buildwithnoknok/module-I2C-1.42-display/hardware/BOM_module-I2C-Display_1_42inch.xls

Item # | *Designator | *Qty | Manufacturer | *Mfg Part # | Description / Value | LCSC Part # | *Package/Footprint | Your Instructions / Notes | Substitute
1 | C1, C7 | 2 | YAGEO | CC0603MRX5R8BB106 | 10uF / CAP CER 10uF 25V X5R 0603 | C596327 | C_0603_1608Metric |  | SAMSUNG『 』CL10A106KP8NNNC『 』C19702
2 | C2, C4, C5, C8 | 4 | YAGEO | CC0603KRX7R9BB104 | 0.1uF / CAP CER 100nF 50V X7R 0603 | C14663 | C_0603_1608Metric |  | SAMSUNG『 』CL10B104KA8NNNC『 』C1590
3 | C6 | 1 | YAGEO | CC1206KKX5R8BB226 | 22µF 25V / CAP CER 22uF 25V X5R 1206 | C2178233 | C_0603_1608Metric |  | SAMSUNG『 』CL10A226MP8NUNE『 』C86295
4 | C9 | 1 | YAGEO | CC0603KRX7R9BB105 | 1uF / CAP CER 1uF 50V X7R 0603 | C559769 | C_0603_1608Metric |  | SAMSUNG『 』CL10A105KP8NNNC『 』C26413
5 | D2 | 1 | onsemi | MM3Z3V6T1G | D_Zener | C116949 | D_SOD-323 |  | ROHM『 』UDZVTE-173.6B『 』C209558
6 | D3 | 1 | onsemi | NSR0320MW2T1G | D_Schottky | C48192 | D_SOD-323
7 | D4 | 1 | Hubei KENTO Elec | KT-0603R | LED RED WATER CLEAR 0603 SMD | C2286 | C_0603_1608Metric
8 | DS1 | 1 | EastRising | ER-TFT1.42-1 | 1.42”IPS TFT LCD 80x160 Pixels Display Panel | --- | ER-TFT1.42-1_13pin_solder | https://www.buydisplay.com/1-42-inch-color-80x160-ips-tft-lcd-display-panel-nv3022b-connector
9 | J1, J2 | 2 | JST | SM04B-SRSS-TB(LF)(SN) | JST 4 Pin Qwiic I2C Connector | C160404 | JST_SH_SM04B-SRSS-TB_1x04-1MP_P1.00mm_Horizontal
10 | L1 | 1 | cjiang | FTC252010S4R7MBCA | Inductor 4.7uH | C5832360 | L_Changjiang_FTC252010S
11 | Q1 | 1 | AOS | AO3400A | MOSFET N-CH 30V SOT-23-3L | C20917 | SOT-23
12 | R1 | 1 | YAGEO | RC0603JR-0710RL | 10R | C109317 | R_0603_1608Metric |  | Viking『 』ARG03FTC0100『 』C217691
13 | R10 | 1 | YAGEO | RC0603JR-07100RL | 100R | C110091 | R_0603_1608Metric |  | Viking『 』ARG03FTC1000『 』C217683
14 | R2 | 1 | YAGEO | RC0603JR-0710KL | 10k | C99198 | R_0603_1608Metric |  | Viking『 』ARG03FTC1002『 』C217687
15 | R3 | 1 | YAGEO | RC0603JR-0733KL | 33k | C138564 | R_0603_1608Metric |  | Viking『 』ARG03FTC3302『 』C217971
16 | R4 | 1 | YAGEO | RC0603JR-0712KL | 12k | C137662 | R_0603_1608Metric |  | Viking『 』ARG03FTC1202『 』C217716
17 | R5 | 1 | YAGEO | RC0603JR-072K2L | 2.2k | C113303 | R_0603_1608Metric |  | Viking『 』ARG03FTC2201『 』C217937
18 | R6, R7 | 2 | YAGEO | RC0603JR-0722RL | 22R | C108405 | R_0603_1608Metric |  | Viking『 』ARG03FTC0220『 』C217888
19 | R8 | 1 | YAGEO | RC0603JR-0733RL | 33R | C108407 | R_0603_1608Metric |  | Viking『 』ARG03FTC0330『 』C217973
20 | R9 | 1 | YAGEO | RC0603JR-07100KL | 100k | C100048 | R_0603_1608Metric |  | Viking『 』ARG03FTC1003『 』C217682
21 | U1 | 1 | WCH | CH32V003F4U6 | CH32V003F4U6 | C5299908 | QFN-20-1EP_3x3mm_P0.4mm_EP1.65x1.65mm
22 | U2 | 1 | XI'AN Aerosemi Tech | MT3540-F23 | MT3540-F23 | C181783 | SOT-23-5
