buildwithnoknok/module-I2C-1.42-display/hardware/module-I2C-Display_1_42inch_Schematics.pdf

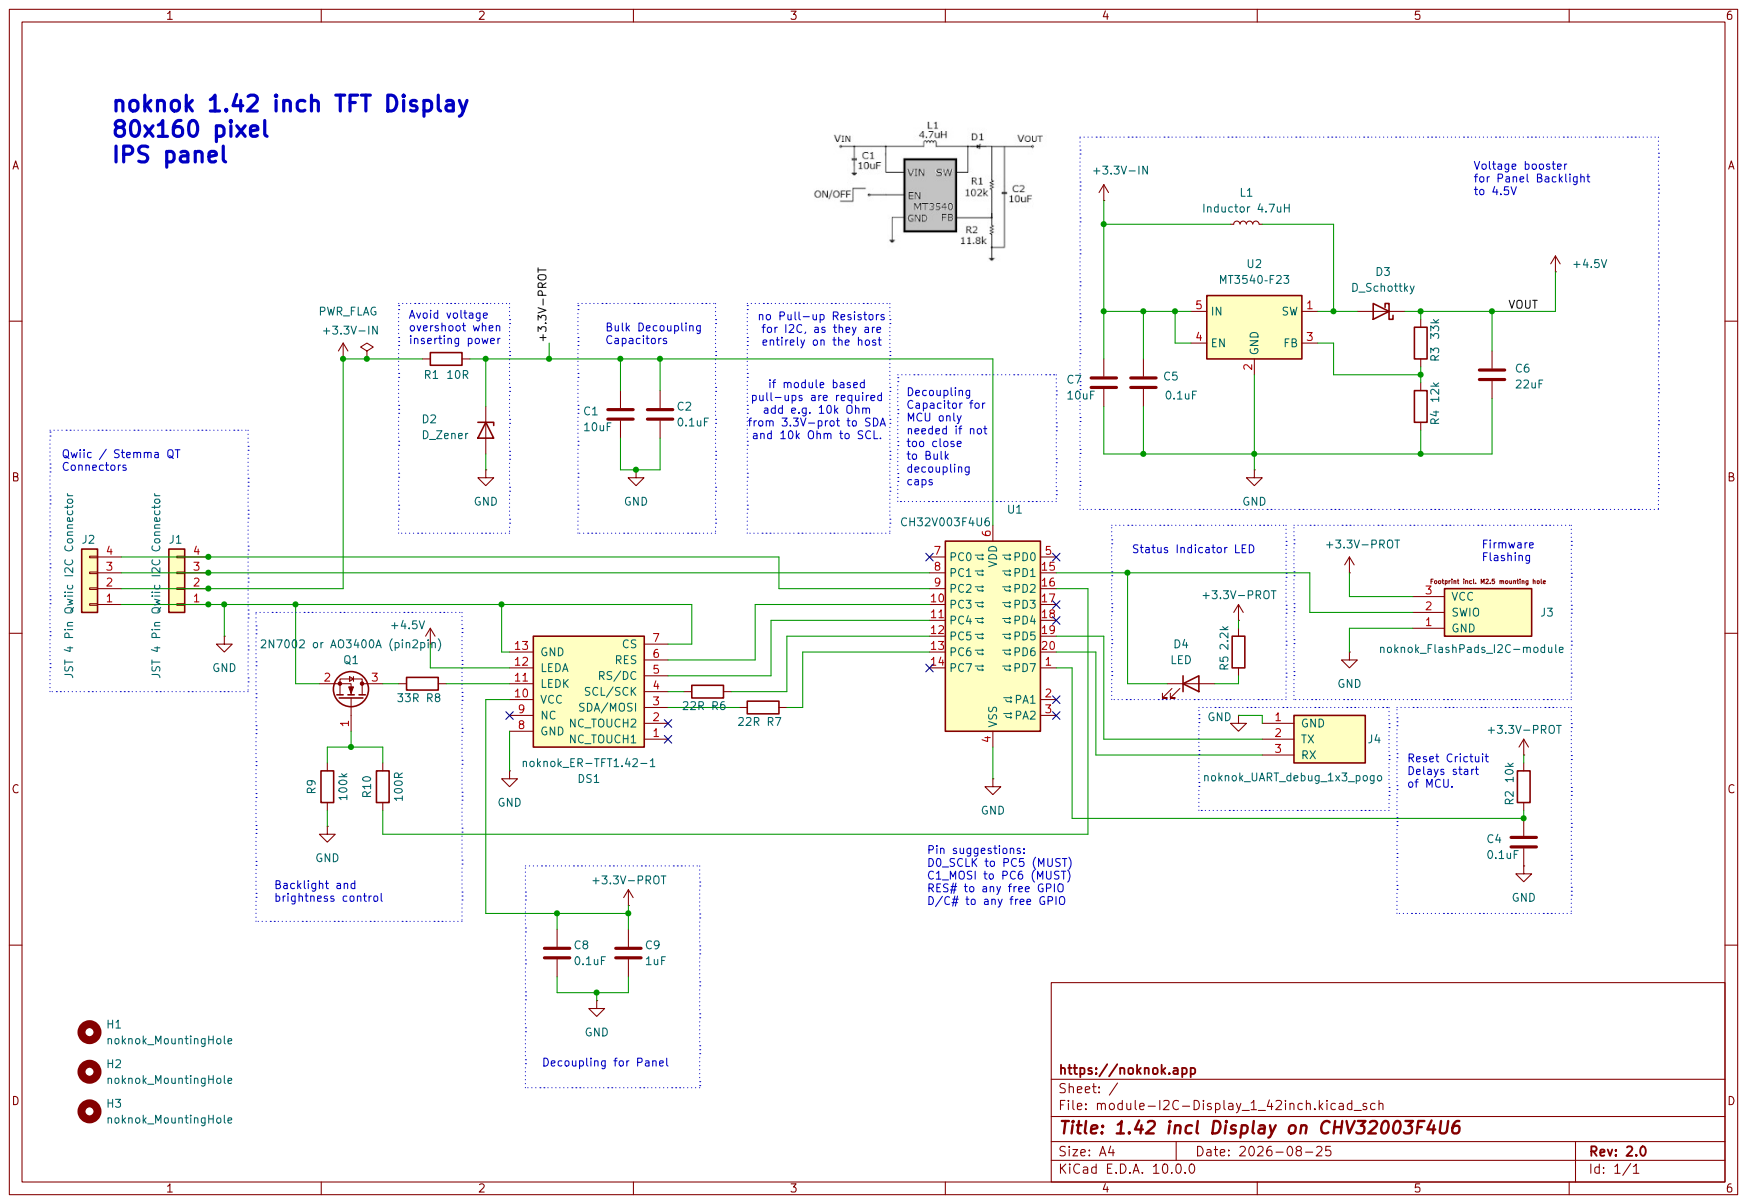
[picture p1: page 1]
