buildwithnoknok/module-I2C-1.42-display/hardware/kicad/module-I2C-Display_1_42inch.kicad_pcb

## KiCad design hardware/kicad/module-I2C-Display_1_42inch.kicad_pcb (2026-08-25)

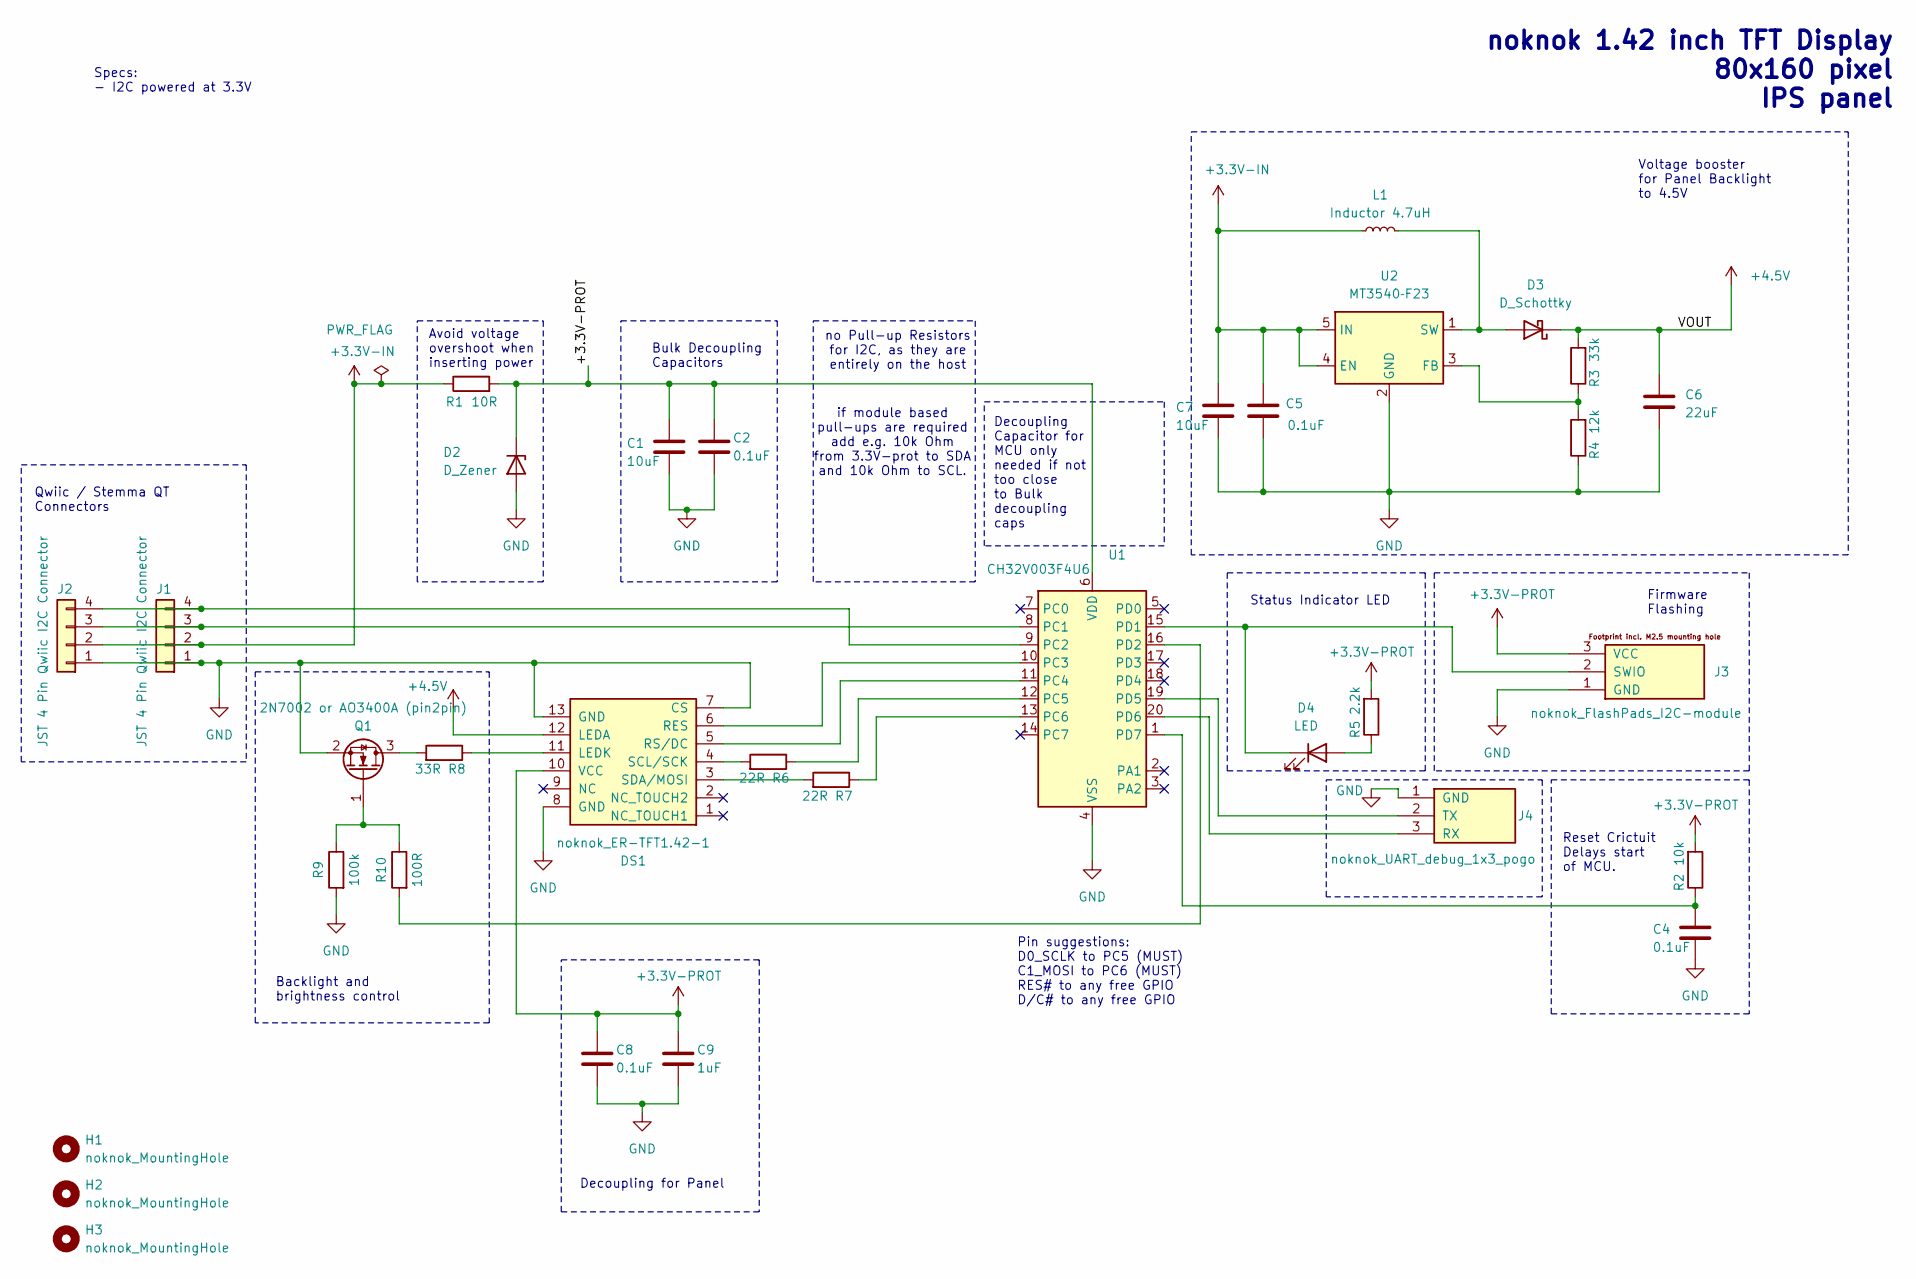
[picture p2: schematic module-I2C-Display_1_42inch.kicad_sch, 1.42 incl Display on CHV32003F4U6]

Parts:
C1, C7: 10uF; C_0603_1608Metric
C2, C4, C5, C8: 0.1uF; C_0603_1608Metric
C6: 22uF; C_0603_1608Metric
C9: 1uF; C_0603_1608Metric
D2: D_Zener; D_SOD-323
D3: D_Schottky; D_SOD-323
D4: LED; LED_0603_1608Metric
DS1: noknok_ER-TFT1.42-1; noknok_ER-TFT1.42-1_13pin_solder_proto
H1, H2, H3: noknok_MountingHole; noknok_MountingHole_2.5mm_M2.5
J1, J2: JST 4 Pin Qwiic I2C Connector; JST_SH_SM04B-SRSS-TB_1x04-1MP_P1.00mm_Horizontal
J3: noknok_FlashPads_I2C-module; noknok_FlashPads_I2C-module_1x3_M2.5
J4: noknok_UART_debug_1x3_pogo
L1: Inductor 4.7uH; L_Changjiang_FTC252010S
Q1: 2N7002 or AO3400A (pin2pin); SOT-23
R1: 10R; R_0603_1608Metric
R2: 10k; R_0603_1608Metric
R3: 33k; R_0603_1608Metric
R4: 12k; R_0603_1608Metric
R5: 2.2k; R_0603_1608Metric
R6, R7: 22R; R_0603_1608Metric
R8: 33R; R_0603_1608Metric
R9: 100k; R_0603_1608Metric
R10: 100R; R_0603_1608Metric
U1: CH32V003F4U6; QFN-20-1EP_3x3mm_P0.4mm_EP1.65x1.65mm
U2: MT3540‑F23; SOT-23-5

Connections:
+3.3V-IN: C5.1, C7.1, J1.2, J2.2, L1.1, R1.1, U2.4 (EN), U2.5 (IN)
+3.3V-PROT: C1.1, C2.1, C8.1, C9.1, D2.1 (K), DS1.10 (VCC), J3.3 (VCC), R1.2, R2.2, R5.2, U1.6 (VDD)
+4.5V: C6.1, D3.1 (K), DS1.12 (LEDA), R3.2
GND: C1.2, C2.2, C4.2, C5.2, C6.2, C7.2, C8.2, C9.2, D2.2 (A), DS1.7 (CS), DS1.8 (GND), DS1.13 (GND), J1.1, J2.1, J3.1 (GND), J4.1 (GND), Q1.2 (S), R4.1, R9.2, U1.4 (VSS), U1.21 (VSS), U2.2 (GND)
unnamed: D3.2 (A), L1.2, U2.1 (SW)
unnamed: D4.2 (A), R5.1
unnamed: D4.1 (K), J3.2 (SWIO), U1.15 (PD1)
unnamed: DS1.11 (LEDK), R8.1
unnamed: DS1.6 (RES), U1.10 (PC3)
unnamed: DS1.5 (RS/DC), U1.11 (PC4)
unnamed: DS1.4 (SCL/SCK), R6.2
unnamed: DS1.3 (SDA/MOSI), R7.2
unnamed: J1.3, J2.3, U1.8 (PC1)
unnamed: J1.4, J2.4, U1.9 (PC2)
unnamed: J4.3 (RX), U1.20 (PD6)
unnamed: J4.2 (TX), U1.19 (PD5)
unnamed: Q1.3 (D), R8.2
unnamed: Q1.1 (G), R9.1, R10.1
unnamed: R6.1, U1.12 (PC5)
unnamed: R7.1, U1.13 (PC6)
unnamed: R10.2, U1.16 (PD2)
unnamed: C4.1, R2.1, U1.1 (PD7)
unnamed: R3.1, R4.2, U2.3 (FB)

Notes on the sheet:
Voltage booster for Panel Backlight to 4.5V
if module based pull-ups are required add e.g. 10k Ohm from 3.3V-prot to SDA and 10k Ohm to SCL.
Decoupling Capacitor for MCU only needed if not too close to Bulk decoupling caps
Avoid voltage overshoot when inserting power
Specs: - I2C powered at 3.3V
noknok 1.42 inch TFT Display 80x160 pixel IPS panel
Pin suggestions: D0_SCLK to PC5 (MUST) C1_MOSI to PC6 (MUST) RES# to any free GPIO D/C# to any free GPIO
no Pull-up Resistors for I2C, as they are entirely on the host
Decoupling for Panel
Reset Crictuit Delays start of MCU.
Status Indicator LED
Firmware Flashing
Backlight and brightness control
Qwiic / Stemma QT Connectors
Bulk Decoupling Capacitors

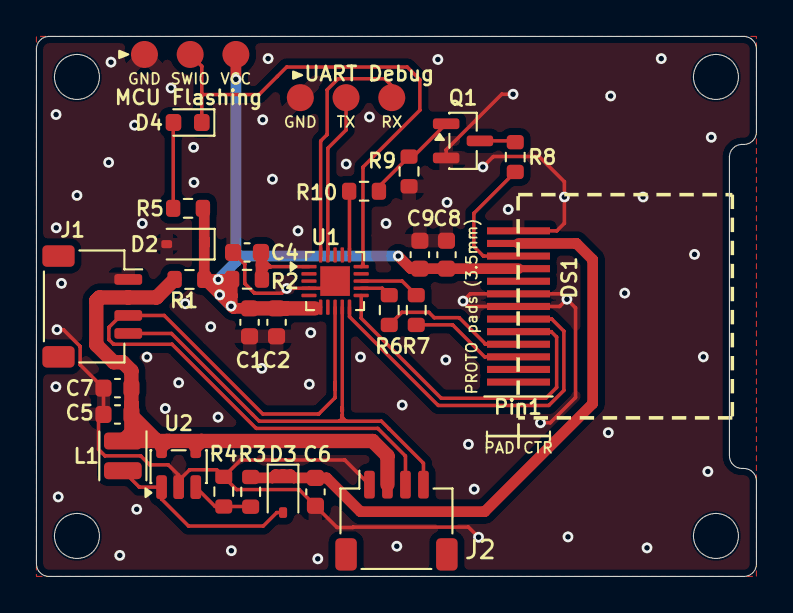
[picture p3: board module-I2C-Display_1_42inch.kicad_pcb from above]

Board: 2 copper layers, 40.0 x 30.0 mm, 33 parts (0 on the bottom side), 23 nets.
