buildwithnoknok/module-I2C-1.42-display/(commit log)

2026-06-30 Add README for the 1.42in I2C display module
    CH32V003 GPU + ER-TFT1.42-1 80x160 IPS panel (NV3022B), 4-wire SPI,
    MT3540 backlight boost. Overview, pinout, architecture, KiCad lib refs,
    firmware TODO and next steps. In development (schematic done, pre-prototype).
2026-06-30 Add KiCad hardware (schematic) + LICENSE files + .gitignore
    hardware/ = KiCad project (schematic). LICENSE = MIT (firmware),
    LICENSE-hardware = CC BY-SA 4.0 (hardware), per the noknok open standard.
    [module-I2C-Display_1_42inch.kicad_pcb, module-I2C-Display_1_42inch.kicad_sch]
2026-07-05 mechanical: add housing.json (40x30 confirmed from KiCad)
    PCB 40x30, panel glass 36.52x18.08. README still says ~24x42 - to be corrected.
2026-07-05 docs: correct PCB dimensions to 40x30 mm (was ~24x42)
    Board is 40x30 (sent to PCBWay at these dims); 4x M2.5 holes 2.25 mm from
    corners, JST-SH on W+S edges. Matches mechanical/housing.json.
2026-07-06 mechanical: display housing profile from production data
    Board 40x30 (gerber). clearance_top=2.0 (panel only 2 mm above PCB). Window =
    active area 32.35x16.18, centred; glass 36.52x18.08 framed by the bezel.
    Connectors W+S, 4x M2.5 corners. First window feature + non-20x20 module.
2026-07-23 firmware: add standalone hardware bring-up build for the first assembled boards
    Bench-only image, linked at 0x0000 and SWD-flashed (does NOT run under the
    shared I2C bootloader, not an I2C module yet). Answers the three unknowns on
    a new board:
    - backlight chain (MT3540 boost / 33R ballast / 2N7002 on PD2) via a PWM ramp
    with the panel held in reset
    - SPI link to the NV3022B (hardware SPI1, transmit-only, no bit-banging)
    - the column/row OFFSET of the 80x160 visible window inside the controller
    GRAM, which is undocumented for this panel: the firmware sweeps a list of
    candidate offsets, ~3s each, blinking the status LED N times per candidate
    and drawing a full-screen border + 4 corne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
    [display_bringup.c]
2026-07-23 mechanical: correct housing profile from production data and first boards
    Re-derived from the production Edge_Cuts gerber, the PCBWay placement CSV and
    the KiCad PCB, now that physical modules exist.
    - Documented the orientation properly: this is the only noknok module whose
    payload sits on KiCad's BOTTOM side. The TFT is bonded to the bare B side and
    its 13-pin FPC wraps around the EAST board edge to solder pads on the F side,
    which also carries the MCU, the boost converter and both JST-SH sockets.
    - Coordinates are the payload view, the same convention as the buzzer, knob and
    ledbutton profiles. J2 therefore lands on the N edge at y=26.9. The previous
    file had J1 in the payload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
2026-07-23 firmware+docs: bring-up diagnostics and the rev 1.0 mirrored-FPC finding
    Adds the bench diagnostics written while bringing up the first boards:
    alive_test (LED + backlight PWM), swio_alive (printf over SWIO, proves the
    CPU executes), backlight_static (PD2 as plain GPIO, no TIM1), led_alive
    (LED lit before SystemInit) and diag (toggles PD2 and prints GPIOD
    CFGLR/OUTDR/INDR - INDR reads the physical pad, which is what finally
    proved the MCU side was healthy).
    README now documents the rev 1.0 defect: the FPC footprint pad order was
    mirrored, so the panel mounted backwards and nothing could work. Footprint
    fixed in Ecosystem cb83a33; layout needs re-import and the board a respin.
    Co-Authored-B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
    [alive_test.c, backlight_static.c, diag.c, led_alive.c, swio_alive.c]
2026-07-23 firmware: PANEL_ROTATED_REWORK switch for rescued rev 1.0 boards
    A rev 1.0 board can be rescued for bench use by desoldering the panel and
    re-soldering it rotated 180 degrees in the plane of the board, which reverses
    the FPC finger order and undoes the mirrored footprint. The panel then hangs
    off the board (bench only, no housing) and its image is upside down.
    New PANEL_ROTATED_REWORK define selects MADCTL 0xC0 (MY|MX) to cancel the
    physical rotation in the controller. Set it to 0 for corrected batch-2 boards.
    Builds clean at 1960B.
    [display_bringup.c]
2026-07-24 firmware: lock in GRAM offset 24,0, minimal init and INVON
    Bench-confirmed on a reworked board: candidate 3 of the offset sweep aligned
    perfectly, so the 80x160 window sits at (24,0). The generic vendor init table
    is replaced by a minimal 5-command DCS init (the vendor table produced a dead
    screen on four boards). INVON added - without it every colour renders inverted.
    Adds OFFSET_CONFIRMED mode which skips the sweep and draws a colour
    verification pattern, plus panel_flood_min.c and the panel_probe read-back
    diagnostic.
    [display_bringup.c, panel_flood.c, panel_flood_min.c, panel_probe.c]
2026-07-24 firmware: display module v0.1.0 - enumeration, standard commands, GPU basics
    First real module firmware, linked at 0x1000 under the shared I2C bootloader.
    InterruptVector verified at 0x1000. 3096B of the 11KB app region, 124B RAM.
    Includes:
    - enumeration as MODULE_TYPE 0x05 (FNV-1a UID backoff, 10-byte UID response,
    0x1D address assign, re-backoff safety net) - skeleton copied from the
    bench-proven LED Button firmware
    - GET_VERSION (0xB1) and ENTER_BOOTLOADER (0xB0) standard commands
    - GET_INFO (0x15) returning geometry + capabilities, so one Pico-side driver
    can serve every display tier instead of hard-coding 80x160
    - GPU: hardware SPI, minimal DCS init, INVON, GRAM offset (24,0), cl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
2026-07-24 firmware: commit the distributable app binary (display_firmware.bin, 3096B)
    This is the OTA image the Pico flashes over I2C - the offset-linked app only,
    not the bootloader. Force-added because the repo gitignores *.bin, with the
    firmware/bin exception kept for distributable images.
2026-07-24 firmware: v0.2.0 - built-in 8x8 font, DRAW_TEXT and the 1bpp blit path
    4848B of the 11KB app region (43%), 140B RAM, InterruptVector still at 0x1000.
    - font8x8.h: 95 glyphs, ASCII 0x20-0x7E, 760 bytes. GENERATED from
    dhepper/font8x8 which is public domain (Daniel Hepper, after Marcel Sondaar,
    from the public-domain IBM VGA fonts) so it sits inside MIT firmware cleanly.
    Bit order is LSB-first (bit 0 = leftmost pixel) - verified by rendering a
    glyph before committing rather than assuming MSB-first.
    - DRAW_TEXT (0x03): monospace, integer scale 1-4 giving native heights
    8/16/24/32. Opaque draws stream a whole scaled cell in one window; the
    transparent path places set pixels individu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
2026-07-24 firmware: match Sues style-byte layout, scale to 8x, fix transparent blit
    Three corrections after Sue delivered the Pico driver:
    1. DRAW_TEXT style byte now matches noknok.py: bits0-1 = font id,
    bits2-4 = (scale-1), bit7 = transparent background. My brief to Sue listed
    the fields but never the bit packing, so we each picked a different one.
    Hers has more scale headroom, so the firmware moves.
    2. Scale range raised from 1-4 to 1-8, giving native heights 8/16/24/32/40/
    48/56/64. Sue treats 48 and 64 as module-native; with a 4x cap they would
    silently have fallen back to the blit path.
    3. Transparent blit was broken: it skipped opening a GRAM window and then
    streamed pixels a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
    [display_firmware.c]
2026-07-24 firmware: runtime orientation - SET_ROTATION and a raw SET_ORIENT calibrator
    Christopher reports the display stuck in portrait with text reading backwards.
    Geometry was compile-time constants, so nothing could be changed at runtime.
    - Panel width/height and the GRAM offsets are now runtime state (g_w, g_h,
    g_xoff, g_yoff) rather than #defines. Clipping, gpu_clear, glyph bounds, blit
    bounds and GET_INFO all read them, so the host sees 160x80 after a landscape
    rotation without hard-coding anything.
    - SET_ROTATION (0x11): rot 0-3 with a MADCTL table (0x00 / 0x60 MV|MX /
    0xC0 MY|MX / 0xA0 MV|MY), swapping width/height and offsets for landscape.
    On the rescued rev 1.0 boards it adds 18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
    [display_firmware.c]
2026-08-25 hardware: update KiCad layout and schematic, add BOM and schematic PDF
    [BOM_module-I2C-Display_1_42inch.xls, module-I2C-Display_1_42inch.kicad_pcb, module-I2C-Display_1_42inch.kicad_sch]
2026-08-28 firmware: reveal demo - standalone landscape boot-to-life loop
    Marketing firmware for the display module first public reveal video.
    Standalone at 0x0000 (no I2C, no bootloader), runs the panel landscape
    160x80, loops seamlessly: black -> purple noknok wordmark -> Hello,
    World! typed out character by character -> blinking block cursor ->
    backlight fade back to black.
    Panel config is lifted verbatim from the bench-proven bring-up (95ab605):
    minimal DCS init, INVON, GRAM offset (24,0), COLMOD 0x05, PCLK/8. Only
    MADCTL changes, to 0xA0 for landscape; the offset swaps with the MV bit
    to (0,24) and stays valid under the mirror bits because 24 centres the
    80px window in a 128-wide GRAM.
    Adds a pr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
2026-08-28 firmware: reveal demo - real brand logo, un-mirror the panel
    Two bench findings from the first flash.
    MIRRORED IMAGE. Both canonical landscape rotations of the working portrait
    value 0xC0 - 0xA0 (MV|MY) and 0x60 (MV|MX) - come out mirrored left-to-right
    on a rescued board, not merely rotated. This panel needs a non-canonical
    MADCTL: 0x20, which is 0xA0 with MY cleared. That un-mirrors the long axis
    and leaves the short axis alone, so the vertical position is unaffected.
    Neither mirror bit disturbs the offsets - the 160 axis is full-range and 24
    centres the 80px window in a 128-wide GRAM, so both are symmetric.
    LOGO. The wordmark was a font approximation in invented colours. It is now
    the r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
2026-08-28 firmware: reveal demo - dim the backlight to 25% for a dark-room shoot
    Peak backlight was 100% duty, which blows out the camera exposure in a dark
    room and clips the purple toward white. BL_FULL is now 250 of 999.
    Not set lower because perceived brightness goes roughly as luminance^0.45,
    so 25% duty still looks a bit over half as bright. The ladder (150 / 250 /
    400 / 999) is documented at the constant and in the README tweak table.
    All the fades ramp to BL_FULL, so the whole sequence dims coherently and the
    40-step ramp stays smooth at 6 counts per step.
2026-08-28 firmware: reveal demo - gamma-compensate the purple (bench-picked 0xD81C)
    The brand colour #8B00F3 encodes to RGB565 0x881E, and sending that renders
    BLUE on this panel. Cause is gamma, not encoding: the minimal DCS init ships
    no vendor gamma table (the generic one killed the panel during bring-up), so
    the controller runs its power-on default curve, which crushes mid-level
    channels hardest. #8B00F3 is R 54.8% / B 96.8% - the blue sails through while
    the red is flattened out of the mix.
    0xD81C (R27 B28) reads as noknok purple on the panel. It is nominally about
    #DE00E6, a MAGENTA - we send magenta to get purple back out, which is the
    measure of how far off the default red curve is. Picked fr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
2026-08-28 firmware: reveal demo - add the Matrix-homage boot-log tail
    After the Hello, World! beat the screen wipes and a green-on-black boot log
    types out at 22 ms/char, closing on '> follow noknok_' in brand purple with a
    blinking purple cursor. Two typing speeds on purpose: the headline is slow
    and ceremonial at 70 ms/char, the log is fast and urgent.
    NO SCROLLING. The white-rabbit line is 183 px against a 156 px usable width
    so it wraps, but the wrapped total is only 5 rows and 5 x 10 px pitch fits
    the 80 px panel with room to spare, so the feed just types down the screen -
    which reads as a boot log anyway. Worth having: the panel is framebuffer-less
    and the controller's hardware vertical scroll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
2026-08-28 firmware: reveal demo - copy change, 'the world is going modular'
    Replaces 'the modules have you.' No two-row split fits: 'going modular' is
    166 px against the 144 px budget a row needs to leave room for the cursor. So
    it wraps to three rows - the world / is going / modular - which reads well
    anyway, landing 'modular' on a line of its own.
    That makes eleven wrapped rows through the four-row window instead of ten, so
    one extra scroll. Loop goes from ~16 s to ~16.3 s.
    4056 B of 16 KB. Builds clean, no warnings. Built and flashed.
2026-09-11 v0.4.0: DEV-31 hardening C - independent watchdog + boot-attempt handshake with stage-1
    Same change as LED Button v2.3 / buzzer v3.4.0 / knob v2.2.0: IWDG (~2 s)
    started after SystemInit, kicked every main-loop iteration and inside the
    backlight ramp (the one blocking loop here; 200 ms today), BOOT_ATTEMPT_CELL
    cleared when an I2C address is assigned. Panel init delays total ~570 ms,
    well inside the window.
    Builds. NOT bench-tested today - no display on the bench; the edit is the
    template change proven on the LED Button and buzzer.
    [display_firmware.c]
2026-09-11 v0.5.0: relink at 0x1400 (bootloader layout 2, stage-1 grows to 4 KB)
    No behaviour change. Built on the Pi from this source; the .bin is the layout-2 image. Not compatible with the legacy monolithic bootloader or a layout-1 stage-1 (DEV-31).
    [display_firmware.c]
2026-09-11 Add firmware/index.json (current-firmware index)
    Declares the current firmware for this module in the same commit as the
    binary, so the version and the bytes cannot drift apart. Product manifests
    now carry only a floor (min); the brain reads this file to decide what to
    install, and requires_bootloader tells it when an image is NOT installable
    on the module in front of it.
    INERT FOR NOW: this repo is private, so a brain cannot fetch the index over
    a raw URL and the display has no entry in the module registry. Add the
    registry entry when the repo goes public; until then the type is a logged
    no-op and no firmware is managed for it.
    Spec: Ecosystem/software/firmware-index.md
2026-09-19 README known gaps: I2C slave robustness findings (DEV-44)
2026-09-28 firmware: demo - add the pid.codes VID/PID announcement as a second show
    noknok's USB IDs were registered with pid.codes on 28 Sep 2026 (1209/4E4E
    application, 1209/4E42 bootloader), so this is the announcement video.
    Rather than fork the file, SHOW now selects between two script tables:
    SHOW_REVEAL (the original reveal) and SHOW_PIDCODES. Everything else is
    shared - panel init, wordmark intro, gamma-compensated purple, typing speeds,
    the centred-then-scrolling terminal - so a new show costs a table of strings
    and nothing else.
    The script builds to one payoff: the PIDs spell the brand in ASCII. 0x4E is
    'N' and 0x42 is 'B', so 4E4E reads NN (noknok) and 4E42 reads NB (noknok
    Bootloader). Th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
2026-09-28 firmware: demo - land 42 as the pid.codes closing beat
    Christopher confirmed both numbers were deliberate: NN for noknok, NB for the
    bootloader. NK was the obvious second choice for the K in noknok, but 'K' is
    0x4B and too easily misread as 0x48 - so NB, which puts 42 in the bootloader
    PID, the Answer to the Ultimate Question of Life, the Universe and Everything.
    That is a far better ending than the placeholder 'yes, on purpose.', so the
    closing beat is now 'and the 42? / the answer / to it all.'
    The Hitchhiker's line proper does not fit the panel - 'universe, and' alone is
    158 px against the 144 px a row needs to leave the cursor room - so the
    paraphrase carries the reference instead.
    17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
2026-09-29 mechanical: rev 1.1 re-check, housing geometry unchanged
2026-10-01 firmware: demo - rev 1.1 swaps D/C and RES (bench-verified)
    The first small-batch production unit showed a lit backlight and a completely
    blank screen. Rev 1.1 wires the panel control lines the other way round:
    rev 1.0 (reworked bench board) PC3 = D/C, PC4 = RES
    rev 1.1 (production, corrected footprint) PC3 = RES, PC4 = D/C
    Confirmed in hardware/kicad/module-I2C-Display_1_42inch.kicad_pcb: U1 pad 10
    (PC3) -> Net-(DS1-RES), U1 pad 11 (PC4) -> Net-(DS1-RS/DC). SPI was never
    affected - PC5 -> R6 -> SCL/SCK and PC6 -> R7 -> SDA/MOSI is what SPI1's fixed
    alternate function requires, so it could not have moved. CS is still hard-tied
    to GND (DS1 pad 7 -> net GND), so the batch-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
2026-10-01 firmware: rev 1.1 pin swap + un-rotate panel in module and bring-up firmware
    PRODUCTION IMPACT: neither firmware/src/display_firmware.c (the shipping
    module app, v0.3.0) nor firmware/bringup/display_bringup.c could drive a rev
    1.1 board. Both used the rev 1.0 mapping PC3=D/C, PC4=RES, which rev 1.1
    reverses. Symptom on hardware is a lit backlight, a visibly running MCU and a
    completely blank screen, because every command/data decision toggles the
    panel's RESET line while the reset pulse goes to D/C.
    Same BOARD_REV_11 switch as the demo, so the old reworked bench board still
    builds by setting it to 0.
    Also set PANEL_ROTATED_REWORK to 0 in both, which is what its own comment
    always said to d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
    [display_bringup.c, display_firmware.c]
2026-10-01 firmware: v0.6.0 - orientation fixed and fully verified, landscape by default
    Bench session on rev 1.1 production unit 03-8c-ab-cd-6b-95-bc-3c. Flashed as a
    full layout-2 image (stage0+stage1+app) and verified byte-for-byte each time.
    Mirrored text on screen was the symptom that exposed three defects:
    1. gpu_window() used the COMPILE-TIME offsets GRAM_X_OFF/GRAM_Y_OFF and never
    the runtime g_xoff/g_yoff. Those are written by SET_ROTATION and SET_ORIENT
    and were never read, so the rotation API changed MADCTL and the geometry
    but silently dropped the offsets. Half-broken since it was written.
    2. Portrait MADCTL was 0x00, which renders text MIRRORED. A symmetric border
    cannot reve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
    [display_firmware.c]
2026-10-01 firmware: v0.7.0 - EastRising's real init + gamma table; brand purple fixed
    Christopher found the ER-TFT1.42-1 8051 tutorial on buydisplay.com. Porting
    its init sequence FIXES THE BRAND COLOUR: #8B00F3 now renders as actual purple
    on production hardware, bench-confirmed. The compensated 0xD81C value is
    retired - it never enters product code.
    WHY WE SHIPPED A MINIMAL INIT UNTIL NOW, and why it cost us brand colour: with
    no gamma table the controller runs its power-on curve, which maps mid-level
    codes to the wrong voltages. #8B00F3 is R 54.8% / B 96.8%, so the red was
    flattened out while the near-rail blue sailed through, and violet collapsed to
    blue. The gamma block fixes it at the source fo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
    [display_firmware.c]
2026-10-01 housekeeping: ship v0.7.0 binary + index, retire the marketing demos, refresh docs
    BINARY + INDEX. firmware/bin/display_firmware.bin is now the bench-verified
    v0.7.0 app (5500 B, crc32 7e11f0eb) - byte-identical to what is flashed on
    production unit 03-8c-ab-cd-6b-95-bc-3c. firmware/index.json updated to match
    and validated by running the repo's own tools/check_index.py:
    OK: display v0.7.0 5500 bytes crc32 7e11f0eb app.ld ORIGIN 0x1400 layout 2
    The committed binary was still the 5184 B v0.5.0-era build.
    REMOVED firmware/demo/ - the reveal and pid.codes marketing animations.
    Christopher has filmed both and archived the sources with the Instagram posts,
    so they no longer need to live he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
2026-10-04 housing.json: print-tuned values from the 2026-10-03 housing print (see notes)
2026-10-23 DEV-44: Display fw 0.7.1 - I2C slave hardening
    - error byte is read-to-clear on a status read
    - STOPF snapshots rx_buf into cmd_buf (only after an address match) and
    resets rx_len, so a bare STOP (host i2c.deinit) no longer re-runs the
    previous command (stray error 4)
    - an address match can no longer wipe a command not yet processed
    Protocol unchanged. Bench-verified on Pi4RFID (production unit).
    [display_firmware.c]
2026-10-23 DEV-44: bench scripts for the I2C slave robustness checks
